extinct00/OrthoTest/AliExpress_pico_clone/Snímek obrazovky 2025-07-19 012632.png

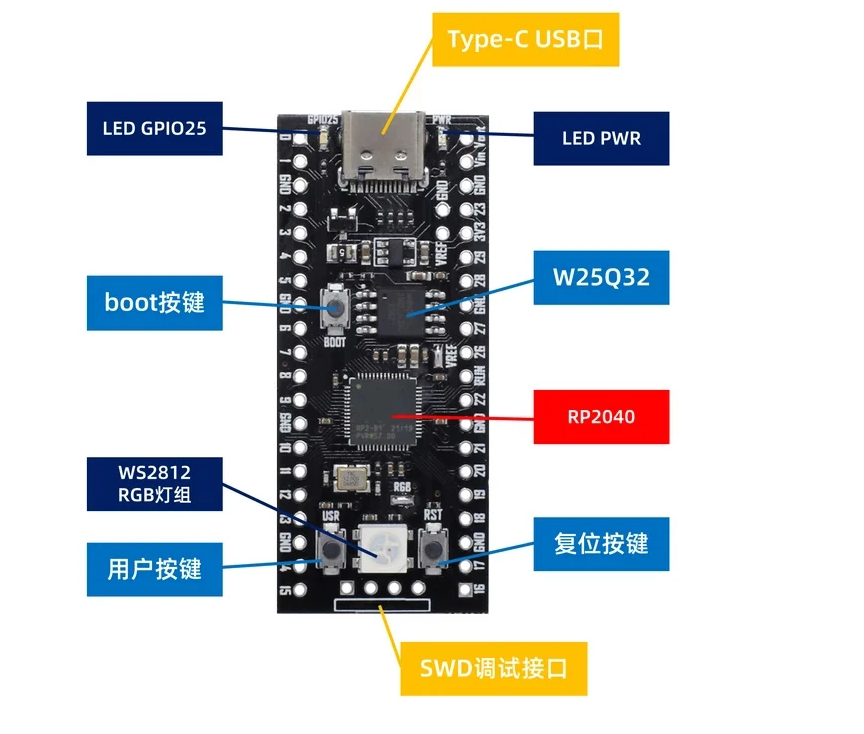
AliExpress_pico_clone/Snímek obrazovky 2025-07-19 012632.png
