extinct00/OrthoTest/KLE_v2/orthotest(1).jpg

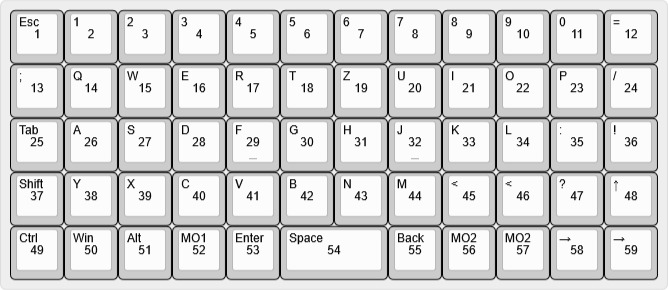
KLE_v2/orthotest(1).jpg
