extinct00/OrthoTest/PCB/OrthoTest/production/bom.csv

Designator | Footprint | Quantity | Value | LCSC Part #
A1 | RaspberryPi_Pico_Common_THT | 1 | RaspberryPi_Pico
C1, C10, C11, C12, C13, C14, C15, C16, C17, C18, C19, C2, C20, C21, C22, C23, C24, C25, C26, C27, C28, C29, C3, C30, C31, C32, C33, C34, C35, C36, C37, C38, C39, C4, C40, C41, C42, C43, C44, C45, C46, C47, C48, C49, C5, C50, C51, C52, C53, C54, C55, C56, C57, C58, C59, C6, C7, C8, C9 | 0603 | 59 | 100n
D1, D10, D11, D12, D13, D14, D15, D16, D17, D18, D19, D2, D20, D21, D22, D23, D24, D25, D26, D27, D28, D29, D3, D30, D31, D32, D33, D34, D35, D36, D37, D38, D39, D4, D40, D41, D42, D43, D44, D45, D46, D47, D48, D49, D5, D50, D51, D52, D53, D54, D55, D56, D57, D58, D59, D6, D60, D61, D7, D8, D9 | D_SOD-123_SmallArrow | 61 | D
LED1, LED10, LED11, LED12, LED13, LED14, LED15, LED16, LED17, LED18, LED19, LED2, LED20, LED21, LED22, LED23, LED24, LED25, LED26, LED27, LED28, LED29, LED3, LED30, LED31, LED32, LED33, LED34, LED35, LED36, LED37, LED38, LED39, LED4, LED40, LED41, LED42, LED43, LED44, LED45, LED46, LED47, LED48, LED49, LED5, LED50, LED51, LED52, LED53, LED54, LED55, LED56, LED57, LED58, LED59, LED6, LED7, LED8, LED9 | LED_6028R | 59 | SK6812MINI-E
S54 | STAB_MX_2u | 1 | MX_stab
SW1, SW10, SW11, SW12, SW13, SW14, SW15, SW16, SW17, SW18, SW19, SW2, SW20, SW21, SW22, SW23, SW24, SW25, SW26, SW27, SW28, SW29, SW3, SW30, SW31, SW32, SW33, SW34, SW35, SW36, SW37, SW38, SW39, SW4, SW40, SW41, SW42, SW43, SW44, SW45, SW46, SW47, SW48, SW49, SW5, SW50, SW51, SW52, SW53, SW54, SW55, SW56, SW57, SW58, SW59, SW6, SW7, SW8, SW9 | SW_Redragon_LowProfile_PCB_1.00u | 59 | SW_Push
SW60, SW61 | RotaryEncoder_Alps_EC11E-Switch_Vertical_H20mm | 2 | RotaryEncoder_Switch_MP
U1 | SSD1306-0.91-OLED-4pin-128x32 | 1 | ~
U5 | SOT-363_SC-70-6 | 1 | SN74LVC1T45DCK
