extinct00/OrthoTest/CAD/Case.stl

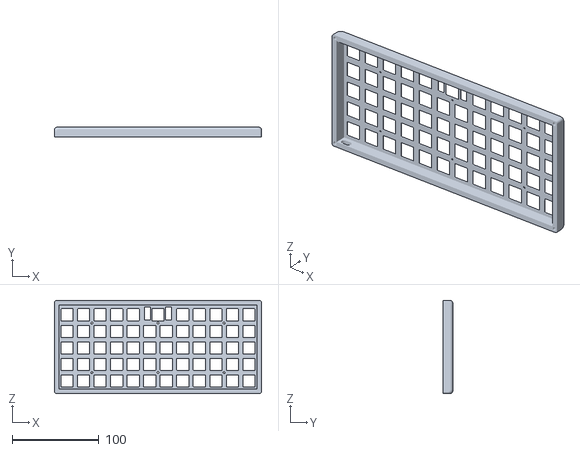
[picture p4: CAD file, 2025-07-13]
CAD/Case.stl
238.6 x 11.2 x 107.2
