extinct00/OrthoTest/CAD/Bottom.stl

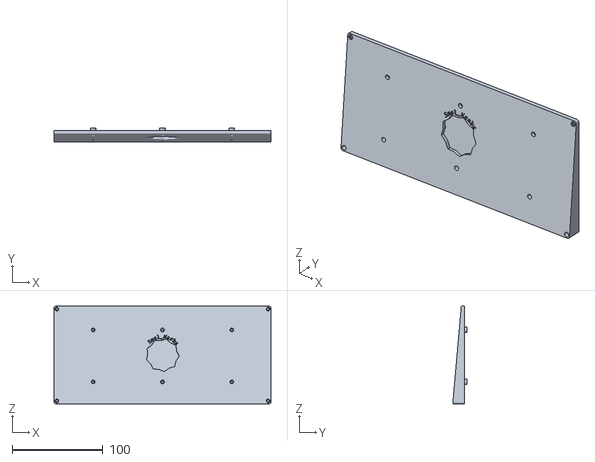
[picture p5: CAD file, 2025-07-13]
CAD/Bottom.stl
238.6 x 15.9 x 107.2
