extinct00/OrthoTest/CAD/Plate_v1.FCStd

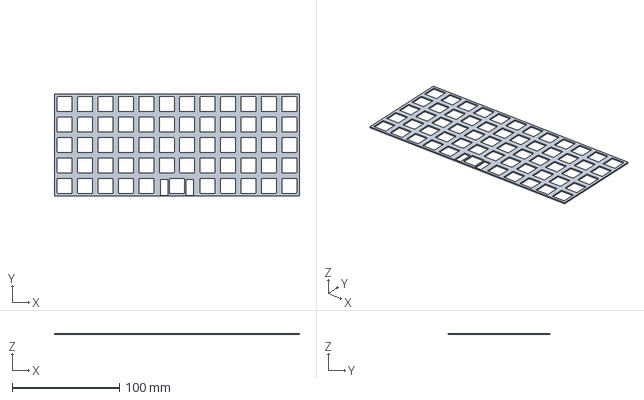
[picture p6: CAD file, 2025-07-13]
CAD/Plate_v1.FCStd
228.6 x 95.2 x 1.20 mm
