extinct00/OrthoTest/CAD/LogoFlower.stl

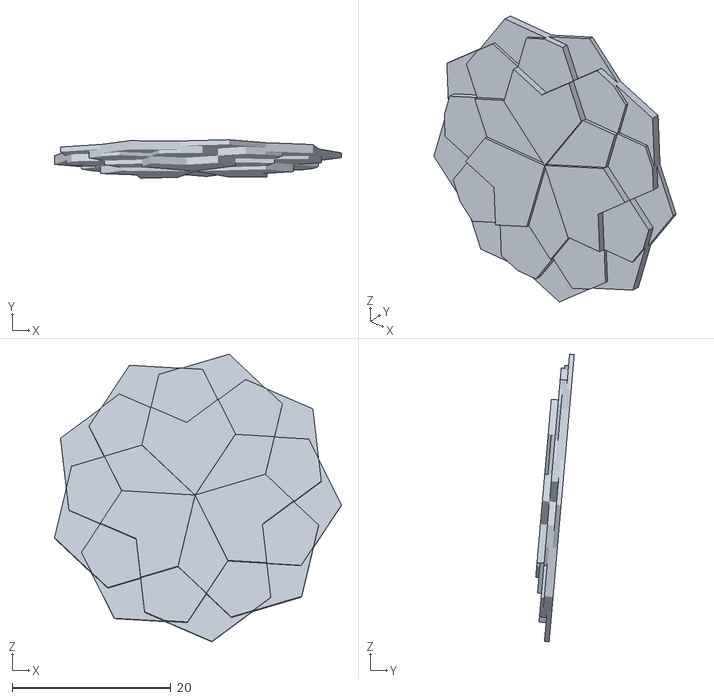
[picture p7: CAD file, 2025-07-13]
CAD/LogoFlower.stl
36.1 x 4.86 x 36.2
