extinct00/OrthoTest/KLE_v1/plate-2025-07-13T02_09_25.887Z.dxf

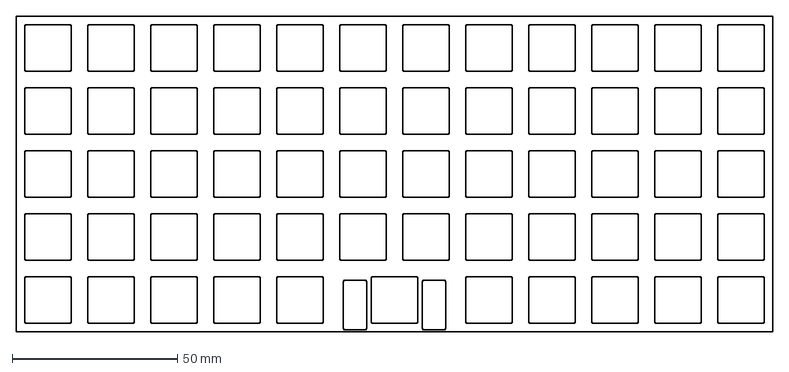
[picture p8: CAD file, 2025-07-13, an earlier design]
KLE_v1/plate-2025-07-13T02_09_25.887Z.dxf
228.6 x 95.2 mm
