extinct00/OrthoTest/(list of files, cad)

Other CAD files:
CAD/Plate_v1-Body.3mf
