extinct00/OrthoTest/(commit log)

2025-07-13 started working on it
    [plate-2025-07-13T02_09_25.887Z.dxf]
2025-07-13 started working on v1
    [Bottom.stl, Case.stl, LogoFlower.stl, OrthoTest.kicad_pcb, OrthoTest.kicad_sch, Plate_v1-Body.3mf, Plate_v1.FCStd]
2025-07-14 worked on it a lil
    [OrthoTest.kicad_sch]
2025-07-14 worked a lil on it
    [OrthoTest.kicad_sch]
2025-07-15 done little work, not enought energy today :(
    [OrthoTest.kicad_pcb, OrthoTest.kicad_sch]
2025-07-16 added libraries and placed pcb components
    [OrthoTest.kicad_pcb, OrthoTest.kicad_sch]
2025-07-17 finished routing pcb
    [OrthoTest.kicad_pcb, OrthoTest.kicad_sch]
2025-07-17 generated gerbers and prod files
    [bom.csv, designators.csv, positions.csv]
2025-07-22 fixed ucontroller usb c position and added grounding vias
    [OrthoTest.kicad_pcb, OrthoTest.kicad_sch]
2025-07-22 spaced encoders additional 10mm aparart
    [OrthoTest.kicad_pcb, bom.csv, designators.csv, positions.csv]
2025-07-23 rerouting ucontroller
    [OrthoTest.kicad_pcb, OrthoTest.kicad_sch]
2025-07-23 added level shifter and finished rerouting
    [OrthoTest.kicad_pcb, OrthoTest.kicad_sch, bom.csv, designators.csv, positions.csv]
